rayanhkhan/SAP1/(list of files, drawings)

Other design files:
SAP1_final.pdsprj
